tengelmann/Lampensteuerung/Web/files/v3_single/v.3 Bestueckung BottomView.TIF

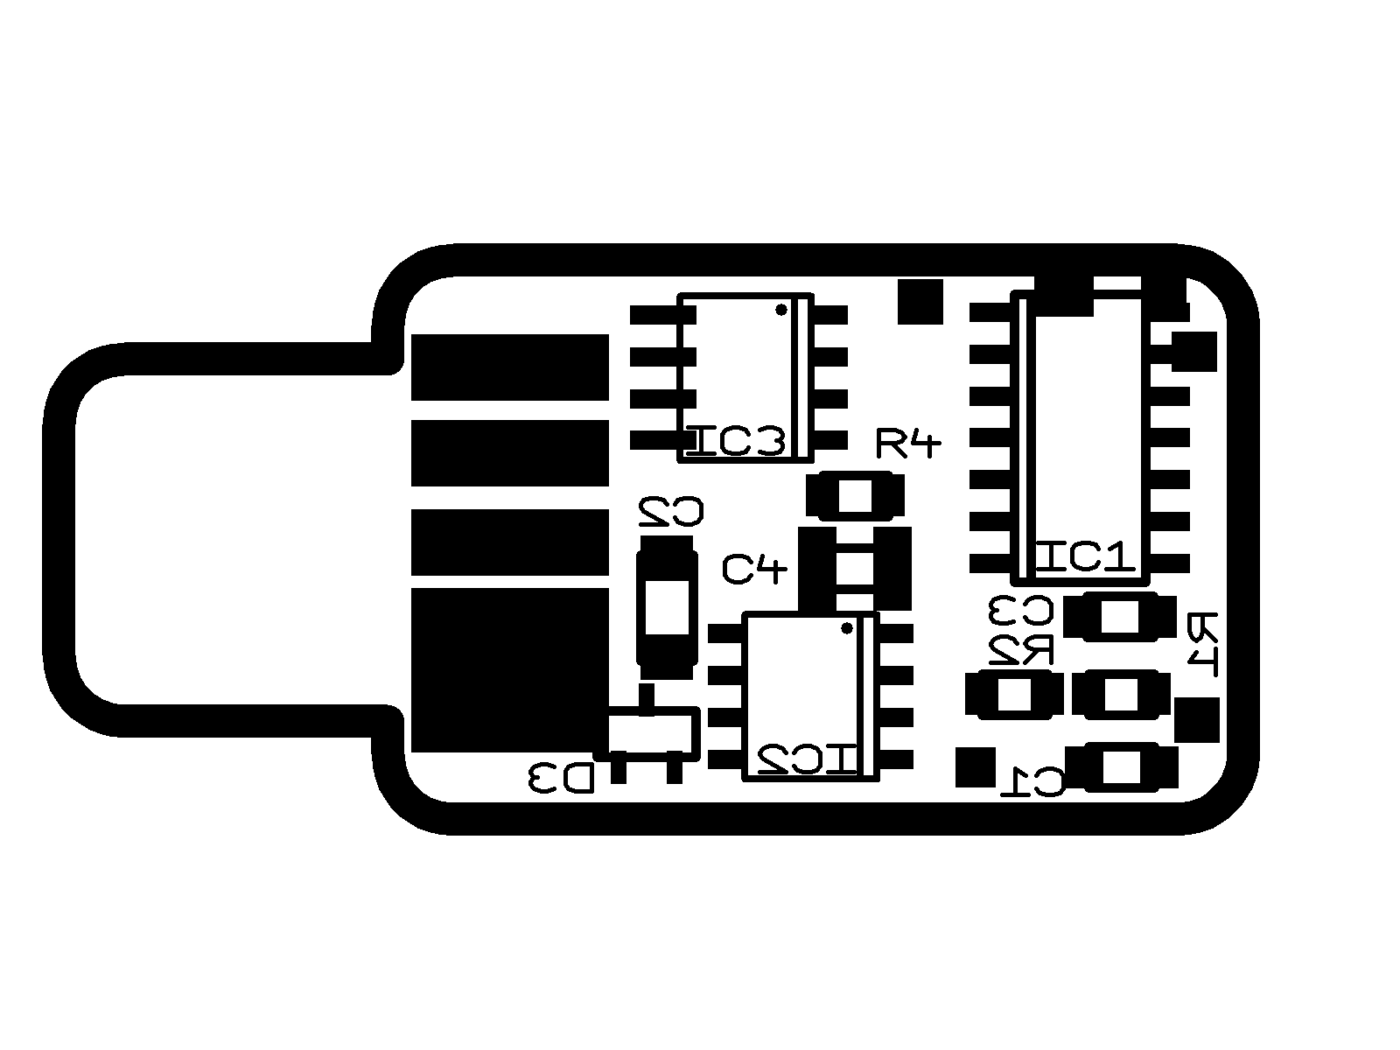
Web/files/v3_single/v.3 Bestueckung BottomView.TIF
