tengelmann/Lampensteuerung/Web/files/v3_single/v.3 Bestueckung TopView.TIF

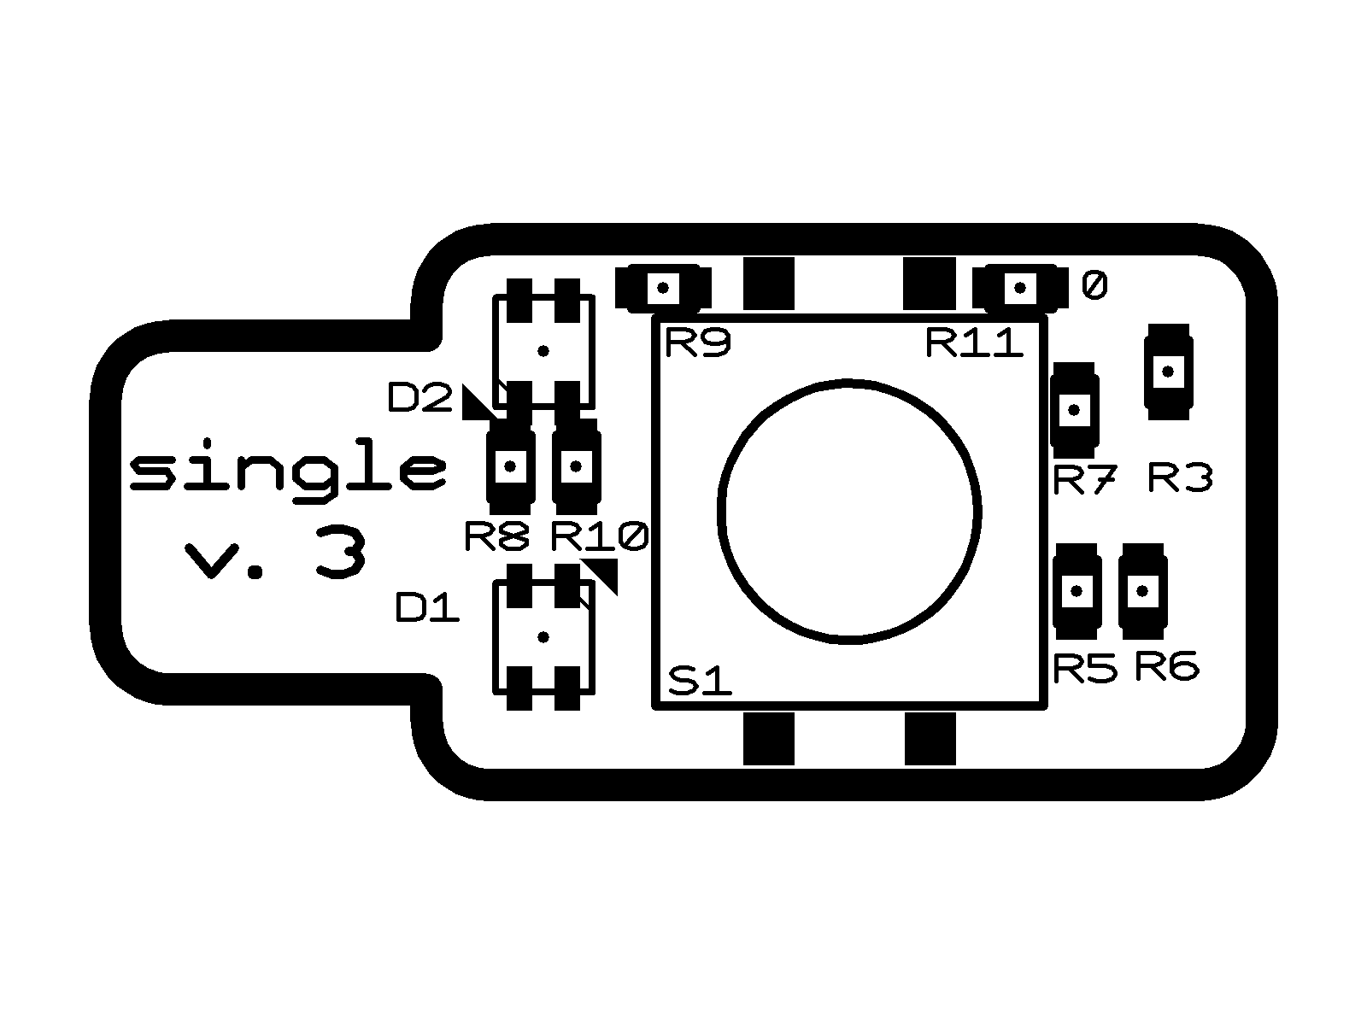
Web/files/v3_single/v.3 Bestueckung TopView.TIF
