tengelmann/Lampensteuerung/Web/images/duov2/duov2.jpg

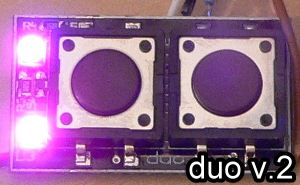
Web/images/duov2/duov2.jpg
