tengelmann/Lampensteuerung/Web/images/duov2/lampe_komplett.jpg

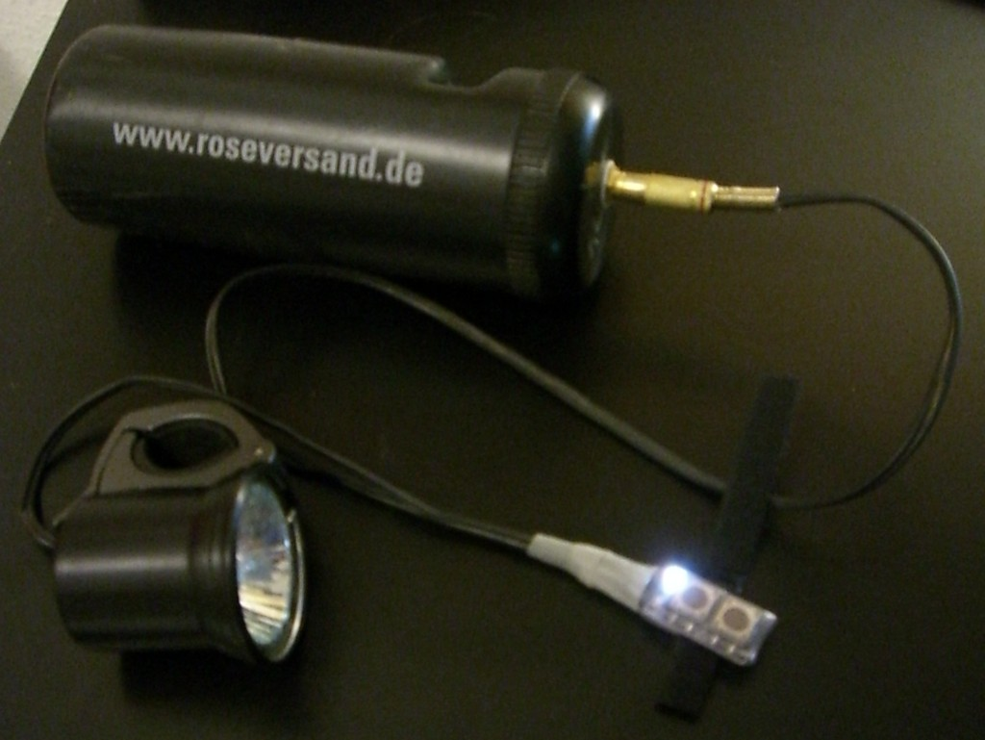
Web/images/duov2/lampe_komplett.jpg
