tengelmann/Lampensteuerung/Web/images/duov2/lenker.jpg

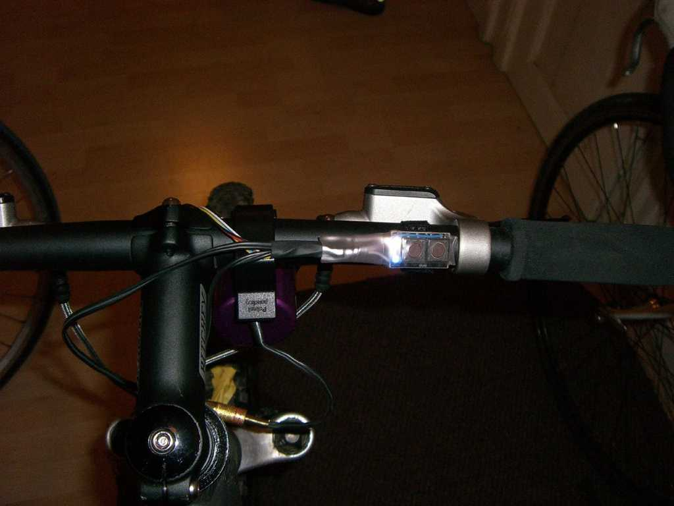
Web/images/duov2/lenker.jpg
