tengelmann/Lampensteuerung/Web/images/duov2/lenker_2.jpg

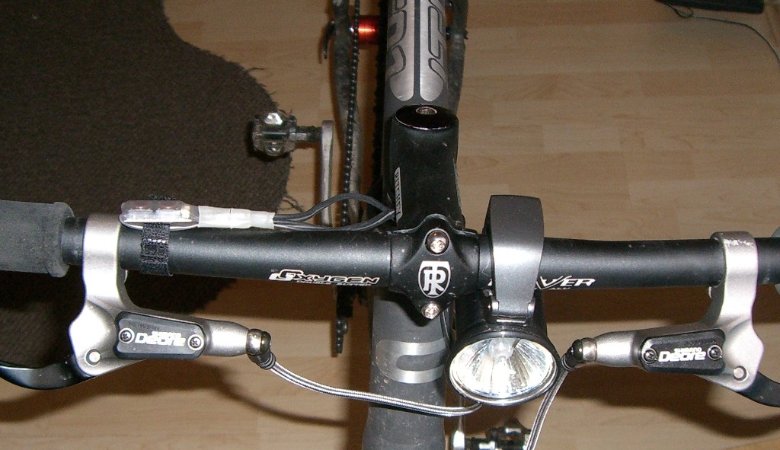
Web/images/duov2/lenker_2.jpg
