tengelmann/Lampensteuerung/Web/images/duov2/lenker_3.jpg

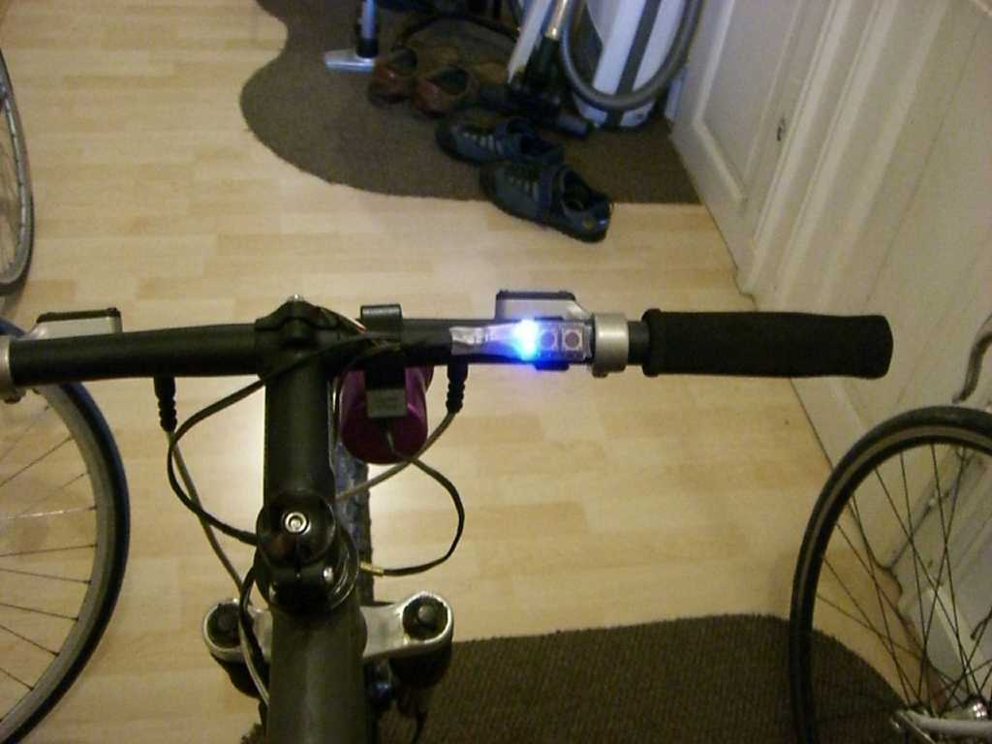
Web/images/duov2/lenker_3.jpg
