tengelmann/Lampensteuerung/Web/images/singlev3.jpg

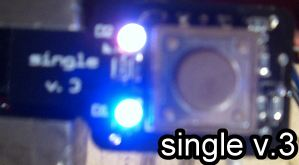
Web/images/singlev3.jpg
