tengelmann/Lampensteuerung/Web/images/singlev3/singlev3_breite.jpg

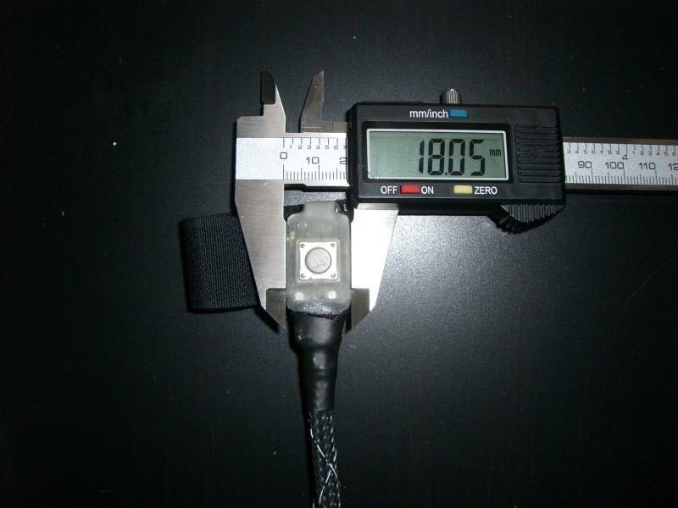
Web/images/singlev3/singlev3_breite.jpg
