tengelmann/Lampensteuerung/Web/images/singlev3/singlev3_set.JPG

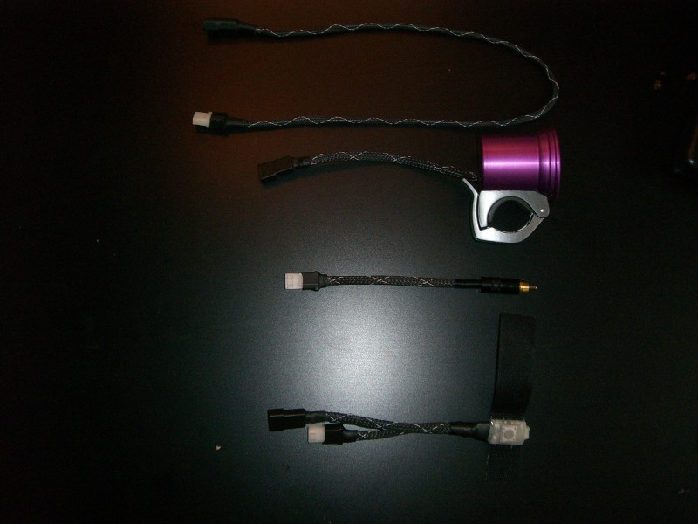
Web/images/singlev3/singlev3_set.JPG
