tengelmann/Lampensteuerung/Web/images/singlev3/singlev3_set_mit_akku.JPG

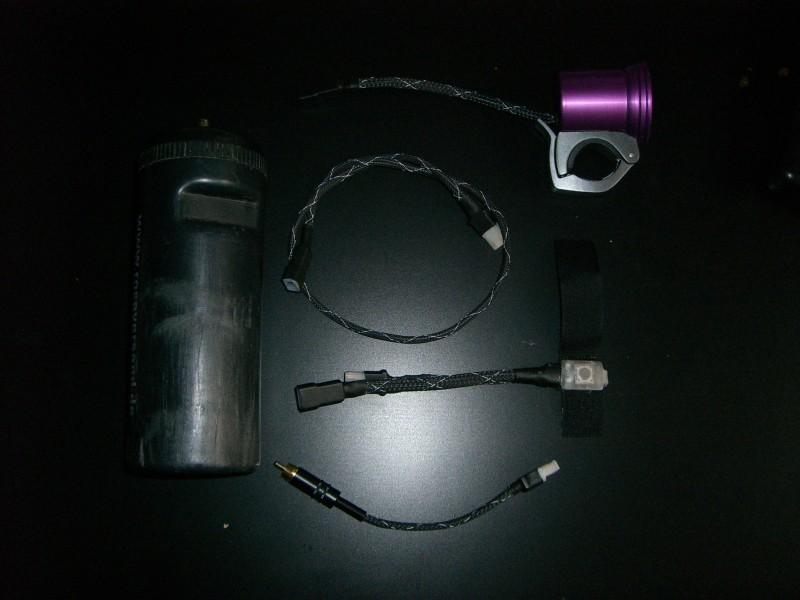
Web/images/singlev3/singlev3_set_mit_akku.JPG
