tengelmann/Lampensteuerung/Web/images/singlev3/singlev3_vergleich_2euro.jpg

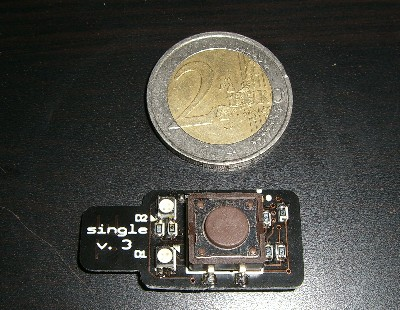
Web/images/singlev3/singlev3_vergleich_2euro.jpg
