tengelmann/Lampensteuerung/Web/images/sis.jpg

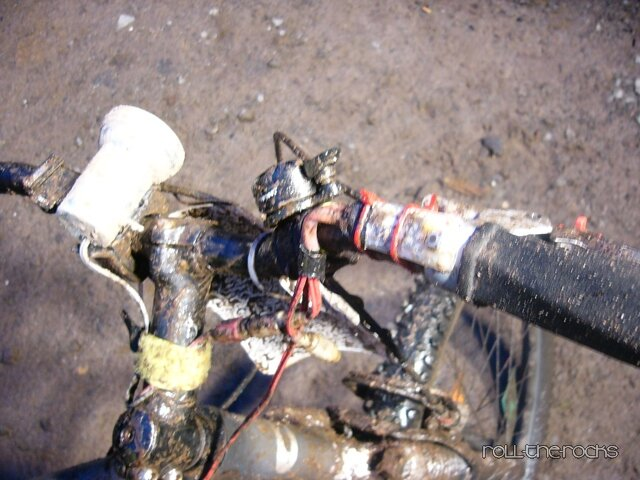
Web/images/sis.jpg
