tengelmann/Lampensteuerung/Web/images/skizze_verkabelung.gif

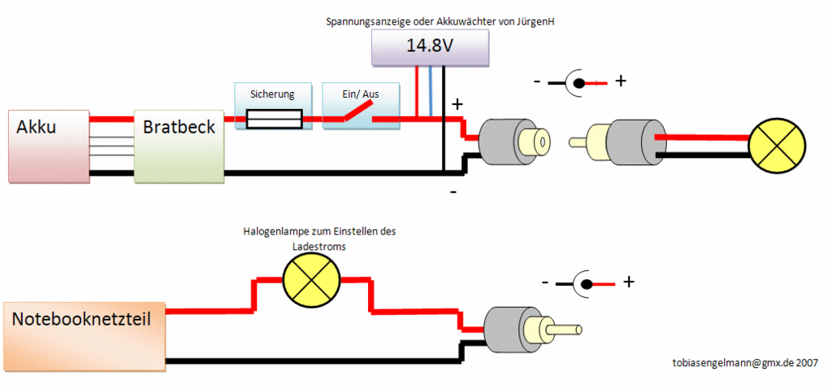
Web/images/skizze_verkabelung.gif
