tengelmann/Lampensteuerung/Web/images/wald.JPG

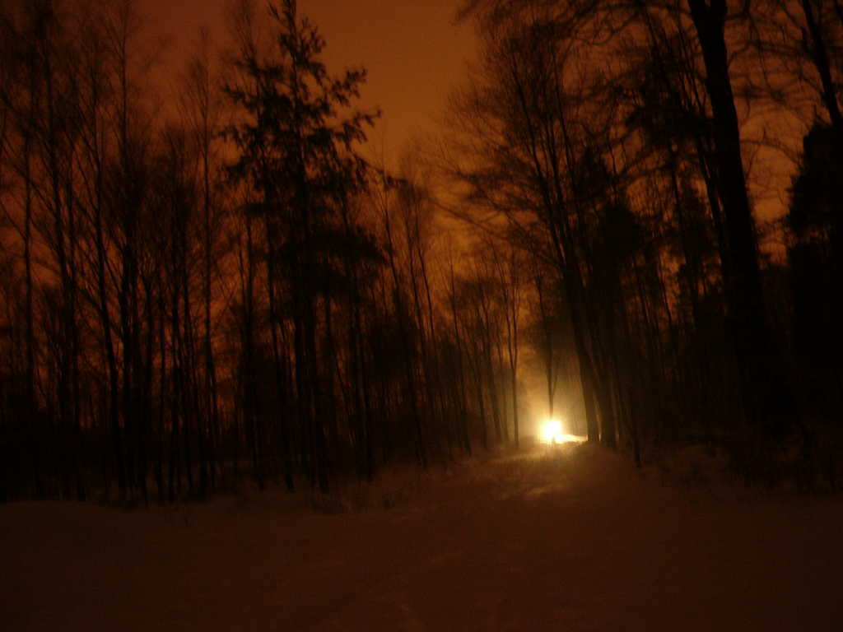
Web/images/wald.JPG
