tengelmann/Lampensteuerung/Web/files/v2_duo/v.2 Stueckliste.xls

2007-12-20
Duo v.2 - 2 Ausgänge - Vcc=5V
 | Wert | Bauform | Anzahl | Reichelt | € | Conrad | € | eBay | € | €
C1 | KERKO 2,2µF 16V | 0805 oder 1206 | 1 |  |  | 445343 - 62 | 0.08 € |  |  | 0.08 €
C2 | KERKO 1µF 25V | 1206 | 1 |  |  | 445475 - 62 | 0.17 € |  |  | 0.17 €
C3 | Kerko 100nF | 0805 oder 1206 | 1 |  |  | 445198-62 | 0.08 € |  |  | 0.08 €
C4 | KERKO 2,2µF 16V | 0805 oder 1206 | 1 |  |  | 445343 - 62 | 0.08 € |  |  | 0.08 €
D1 | BAS 40-05 (Dual) | SOT23 | 1 |  |  | 153221 - 62 | 0.16 € |  |  | 0.16 € | oder BAV70, Bat54C, Bas40-05
D2 | LED-SMD RGB | PLCC4, Common Anode | 2 |  |  |  |  | ebay z.b. led-baron.de | 0.60 € | 1.20 €
D3 | LED-SMD RGB | PLCC4, Common Anode
IC1 | ATTINY44-20SSU | SO14 | 1 | ATTINY 44-20 SSU | 2.10 € |  |  | csd-electronics.de (*2) | 2.40 € | 2.40 € | oder ATTINY44V-10SSU
IC2 | TA 78 L05 F | HSOP3 | 1 |  |  | 144711 - 62 | 0.71 € |  |  | 0.71 €
IC3 | IRF7313 (6,5A) | SO8 | 1 |  |  | 162452-J7 | 0.87 € |  |  | 0.87 €
R1 | 22K | 0805 | 3 | SMD-0805 22,0K | 0.10 € | 406414 - 62 | 0.10 € |  |  | 0.30 €
R2 | 68K | 0805 | 1 | SMD-0805 68,0K | 0.10 € | 406473 - 62 | 0.10 € |  |  | 0.10 €
R3 | 22K | 0805
R4 | 22K | 0805
R5 | 820 | 0805 | 6 | SMD-0805 820 | 0.10 € | 406244-J7 | 0.10 € |  |  | 0.60 €
R6 | 820 | 0805
R7 | 820 | 0805
R8 | 820 | 0805
R9 | 820 | 0805
R10 | 820 | 0805
S1 | DTSM 21 - Tactile Switch SMT Type 12x12 |  | 1 |  |  | 707589 - 62 | 0.64 € | csd-electronics.de (Art.Nr. 351205) | 0.28 € | 0.64 €
 |  |  |  |  |  |  |  |  |  | 7.39 €
Mail: | tobiasengelmann@gmx.de
ICQ: | 59634313
