tengelmann/Lampensteuerung/Web/files/v3_single/v.3 Stueckliste.xlsx

2007-08-02
Single v.3 Normal - 2 Ausgänge - Vcc=5V
 | Wert | Bauform | Anzahl | Reichelt | € | Conrad | € | eBay | € | €
C1 | KERKO 2,2µF 16V | 0805 | 1 |  |  | 445343 - 62 | 0.08 € |  |  | 0.08 €
C2 | KERKO 1µF 25V | 1206 | 1 |  |  | 445475 - 62 | 0.17 € |  |  | 0.17 €
C3 | Kerko 100nF | 0805 | 1 |  |  | 445198-62 | 0.08 € |  |  | 0.08 €
C4 | KERKO 2,2µF 16V | 0805 | 1 |  |  | 445343 - 62 | 0.08 € |  |  | 0.08 €
D1 | BAS 40-05 (Dual) | SOT23 | 1 |  |  | 153221 - 62 | 0.16 € |  |  | 0.16 €
D2 | LED-SMD RGB | PLCC4, Common Anode | 2 |  |  |  |  | ledbaron.de | 0.60 € | 1.20 €
D3 | LED-SMD RGB | PLCC4, Common Anode
IC1 | ATtiny44 | SO14 | 1 | ATTINY 44-20 SSU | 2.10 € |  |  | csd-electronics.de | 2.40 € | 2.40 €
IC2 | L78L05ACD | SO8 | 1 |  |  | 156058 - 62 | 0.23 € |  |  | 0.23 €
IC3 | IRF7313 (6,5A) | SO8 | 1 |  |  | 162452-J7 | 0.87 € |  |  | 0.87 €
R1 | 22K | 0805 | 3 | SMD-0805 22,0K | 0.10 € | 406414 - 62 | 0.10 € |  |  | 0.30 €
R2 | 68K | 0805 | 1 | SMD-0805 68,0K | 0.10 € | 406473 - 62 | 0.10 € |  |  | 0.10 €
R3 | 22K | 0805
R4 | 22K | 0805
R5 | 820 | 0805 | 6 | SMD-0805 820 | 0.10 € | 406244-J7 | 0.10 € |  |  | 0.60 €
R6 | 820 | 0805
R7 | 820 | 0805
R8 | 820 | 0805
R9 | 820 | 0805
R10 | 820 | 0805
R11 | 0 | 0805 | 1 |  |  | 406007 - 62 | 0.10 € |  |  | 0.10 €
S1 | DTSM 21 - Tactile Switch SMT Type 12x12 |  | 1 |  |  | 707589 - 62 | 0.64 € |  |  | 0.64 €
 |  |  |  |  |  |  |  |  |  | 7.01 €
Mail: | tobiasengelmann@gmx.de
ICQ: | 59634313
Single v.3 Low Voltage - 2 Ausgänge - Vcc=3,3V
 | Wert | Bauform | Anzahl | Reichelt | € | Conrad | € | eBay | € | €
R2 | 115K | 0805 | 1 | SMD-0805 115K | 0.10 € |  |  |  |  | 0.10 €
R5 | 560 | 0805 | 4 | SMD-0805 560 | 0.10 € |  |  |  |  | 0.40 €
R6 | 150 | 0805 | 2 | SMD-0805 150 | 0.10 € |  |  |  |  | 0.20 €
R7 | 560 | 0805
R8 | 560 | 0805
R9 | 560 | 0805
R10 | 150 | 0805
IC2 | L4931CD33 | SO8 | 1 |  |  | 156127 - 62 | 1.22 € |  |  | 1.22 €
IC3 | IRF7301 | SO8 | 1 |  |  | 162443 - 62 | 0.91 € |  |  | 0.91 €
Alle anderen Teile, wie die normale Version.
Single v.3 Low Voltage - Beide Lampenausgänge gekoppelt
 | Wert | Bauform | Anzahl | Reichelt | € | Conrad | € | eBay | € | €
R11, R3 | unbestückt
IC3 | IRF7456 | SO8 | 1 |  |  | 162481 - 62 | 1.33 € |  |  | 1.33 €
Alle anderen Teile, wie normale oder Low-Volt-Version.
