tengelmann/Lampensteuerung/Web/files/v3_single_mod_strommessung/v.3 mit Strommessung Stueckliste.xlsx

2007-08-06
Single v.3 Dicke Platine - 1 Ausgang - Vcc=5V
 | Wert | Bauform | Anzahl | Reichelt | € | Conrad | € | eBay | € | €
C1 | KERKO 2,2µF 16V | 0805 | 1 |  |  | 445343 - 62 | 0.08 € |  |  | 0.08 €
C2 | KERKO 1µF 25V | 1206 | 1 |  |  | 445475 - 62 | 0.17 € |  |  | 0.17 €
C3 | Kerko 100nF | 0805 | 1 |  |  | 445198-62 | 0.08 € |  |  | 0.08 €
C4 | KERKO 2,2µF 16V | 0805 | 1 |  |  | 445343 - 62 | 0.08 € |  |  | 0.08 €
D1 | LED-SMD RGB | PLCC4, Common Anode | 2 |  |  |  |  | ledbaron.de | 0.60 € | 1.20 €
D2 | LED-SMD RGB | PLCC4, Common Anode
D8 | BAS 40-05 (Dual) | SOT23 | 1 |  |  | 153221 - 62 | 0.16 € |  |  | 0.16 €
IC1 | ATtiny44 | SO14 | 1 | ATTINY 44-20 SSU | 2.10 € |  |  | csd-electronics.de | 2.40 € | 2.40 €
IC2 | L78L05ACD | SO8 | 1 |  |  | 156058 - 62 | 0.23 € |  |  | 0.23 €
IC3 | IRF7313 (6,5A) | SO8 | 1 |  |  | 162452-J7 | 0.87 € |  |  | 0.87 €
R1 | 22K | 0805 | 2 | SMD-0805 22,0K | 0.10 € | 406414 - 62 | 0.10 € |  |  | 0.20 €
R2 | 68K | 0805 | 1 | SMD-0805 68,0K | 0.10 € | 406473 - 62 | 0.10 € |  |  | 0.10 €
R3 | 0 | 0805 | 1 |  |  | 406007 - 62 | 0.10 € |  |  | 0.10 €
R4 | 22K | 0805
R5 | 820 | 0805 | 6 | SMD-0805 820 | 0.10 € | 406244-J7 | 0.10 € |  |  | 0.60 €
R6 | 820 | 0805
R7 | 820 | 0805
R8 | 820 | 0805
R9 | 820 | 0805
R10 | 820 | 0805
R11* | unbestückt | 0805
S1 | DTSM 21 - Tactile Switch SMT Type 12x12 |  | 1 |  |  | 707589 - 62 | 0.64 € |  |  | 0.64 €
 |  |  |  |  |  |  |  |  |  | 6.91 €
