tengelmann/Lampensteuerung/Docs/Berechnungen/IRF-Typen in der Übersicht.xlsx

Sheet: IRF Übersicht
Übersicht IRF
Dual-N-Kanal, 5V
IRF | Vdss | Rdson@10V | Rdson@4,50V | Rdson@2,8V | I @ 25°C | I @ 70°C | GC |  |  | 1 | 10 | 25
IRF9910PBF | 20 V | 13.4 mΩ | 18.3 mΩ |  | 10.0 A | 8.3 A |  | rsonline.de |  |  | 1.41 € | 1.28 €
IRF7904UPBF | 30 V | 16.2 mΩ | 20.5 mΩ |  | 7.6 A | 8.9 A
IRF8915 | 20 V | 18.3 mΩ | 27.0 mΩ |  | 8.9 A | 7.1 A
IRF7311 | 20 V |  | 29.0 mΩ | 46.0 mΩ | 6.6 A | 5.3 A | 18.0 nC | Conrad | 162451 - 62 | 2.33 € | 2.09 € | 1.77 €
IRF7331PBF | 20 V |  | 30.0 mΩ | 45.0 mΩ | 7.0 A | 5.5 A |  | Farnell | 9103465 | 1.15 € |  | 0.66 €
IRF7313 | 20 V | 29.0 mΩ | 46.0 mΩ |  | 6.5 A | 5.2 A | 22.0 nC | Conrad | 162452-J7 | 0.89 € | 0.79 € | 0.67 €
IEF7301 | 20 V |  | 50.0 mΩ | 70.0 mΩ | 5.2 A | 4.1 A |  | Conrad | 162443 - 62 | 0.91 € | 0.82 € | 0.70 €
IRF7341 | 55 V | 50.0 mΩ | 56.0 mΩ |  | 4.7 A | 3.8 A | 24.0 nC | Conrad | 162457 - 62 | 1.28 €
IRF7303 | 30 V | 50.0 mΩ |  |  | 4.9 A | 3.9 A |  | Conrad | 162444 - 62 | 1.50 €
IRF8910 | 20 V | 13.4 mΩ |  |  | 10.0 A | 8.3 A
Single-N-Channel, 5V |  |  |  |  |  |  |  |  |  | 1 | 10 | 25
IRF7831 | 30 V | 3.6 mΩ | 4.4 mΩ |  | 21.0 A | 17.0 A | 40.0 nC | Conrad | 164357 - 62 | 2.99 € | 2.79 € | 2.25 €
IRF7456 (https://ec.irf.com/v6/en/US/adirect/ir?cmd=catSearchFrame&domSendTo=byID&domProductQueryName=IRF7456) | 20 V | 6.5 mΩ | 7.5 mΩ | 20.0 mΩ | 16.0 A | 10.0 A | 41.0 nC | Conrad | 162481 - 62 | 1.33 € | 1.20 € | 1.02 €
IRF7476 (https://ec.irf.com/v6/en/US/adirect/ir?cmd=catSearchFrame&domSendTo=byID&domProductQueryName=IRF7476) |  |  | 8.0 mΩ | 30.0 mΩ | 15.0 A | 12.0 A
IRF7455 | 30 V | 7.5 mΩ | 9.0 mΩ | 20.0 mΩ | 15.0 A | 10.0 A |  | Conrad | 162480 - 62 | 3.99 € | 3.43 € | 3.07 €
IRF7457 | 20 V | 7.0 mΩ | 10.5 mΩ |  | 15.0 A | 12.0 A |  | Conrad | 162482 - 62 | 1.63 €
IRF7459 (https://ec.irf.com/v6/en/US/adirect/ir?cmd=catSearchFrame&domSendTo=byID&domProductQueryName=IRF7459) | 20 V | 9.0 mΩ | 11.0 mΩ | 22.0 mΩ | 10.0 A | 8.0 A |  | Conrad | 162484 - 62 | 1.42 € | 1.27 € | 1.08 €
IRF7413 | 30 V | 11.0 mΩ | 18.0 mΩ |  | 13.0 A | 9.2 A | 44.0 nC | Reichelt | IRF 7413 (http://www.reichelt.de/) | 0.67 €
 |  |  |  |  |  |  |  | CSD | 137372 | 0.61 € |  | 0.45 €
IRF7413 | 30 V | 11.0 mΩ | 18.0 mΩ |  | 13.0 A | 9.2 A |  | Conrad | 162474 - 62 | 1.02 €
IRF7403 | 30 V | 22.0 mΩ | 35.0 mΩ |  | 8.5 A | 5.4 A |  | Reichelt | IRF 7403 (http://www.reichelt.de/) | 0.43 €
SI4966DY | 20 V | 25.0 mΩ |  |  | 7.2 A |  |  | Farnell |  | 0.9
162452-S3 IRF 7313 SO 8 30 V 25°C@6.5 A 0.029 Ohm (http://www1.business.conrad.de/scripts/wgate/zcop_b2b/~flN0YXRlPTIxNjczMjY3MDA=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)

Sheet: Tabelle1
 |  |  |  |  | 1 | 10 | 50 | 100
805 | 25 | 2.2 | Farnell | 9527702 (http://de.farnell.com/jsp/Passive+Bauelemente/Kondensatoren/MURATA/GRM21BF51E225ZA01L/displayProduct.jsp?sku=9527702) |  | 0.06 € | 0.05 € | 0.04 €
805 | 6.3 | 4.7 |  | 5212832 (http://de.farnell.com/jsp/Passive+Bauelemente/Kondensatoren/EPCOS/B37641K7475K62/displayProduct.jsp?sku=5212832) |  | 0.11 € | 0.09 € | 0.08 €
1206 | 10 | 10 |  | 9527745 (http://de.farnell.com/jsp/Passive+Bauelemente/Kondensatoren/MURATA/GRM31MF51A106ZA01L/displayProduct.jsp?sku=9527745) |  | 0.12 € | 0.10 € | 0.10 €
1206 | 6.3 | 22 |  | 1288265 |  | 0.59 € |  | 0.50 €
805 | 6.3 | 10 |  | 9227814 |  | 0.29 € |  | 0.26 €
1206 | 6.3 | 10 |  | 9527729 |  | 0.17 € | 0.14 € | 0.13 €
