tengelmann/Lampensteuerung/(list of files, cad)

Other CAD files:
Firmware/AVRootloader/AVR/AVRootloader.obj
Firmware/AVRootloader/Test/AVR/AVRootloader.obj
