tengelmann/Lampensteuerung/Docs/Anleitung/Images/singlev.3 KTY11-5 auf Ledträger T6.jpg

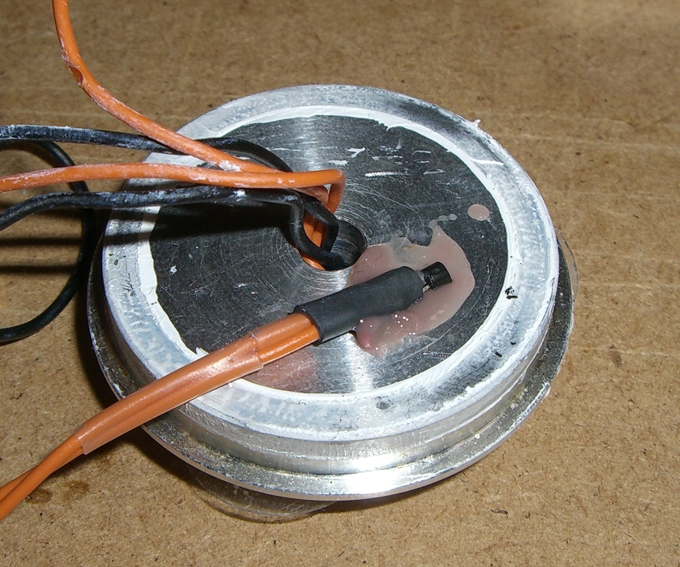
Docs/Anleitung/Images/singlev.3 KTY11-5 auf Ledträger T6.jpg
