tengelmann/Lampensteuerung/Docs/Anleitung/Images/singlev.3 KTY11-5 Kabel an Steuerung.jpg

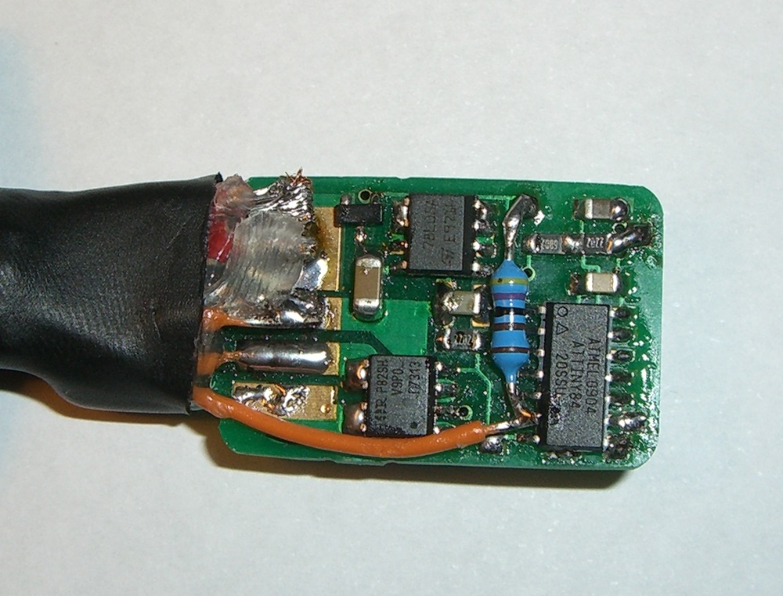
Docs/Anleitung/Images/singlev.3 KTY11-5 Kabel an Steuerung.jpg
