tengelmann/Lampensteuerung/Docs/Anleitung/Images/singlev.3 KTY11-5 Mini-To-92.jpg

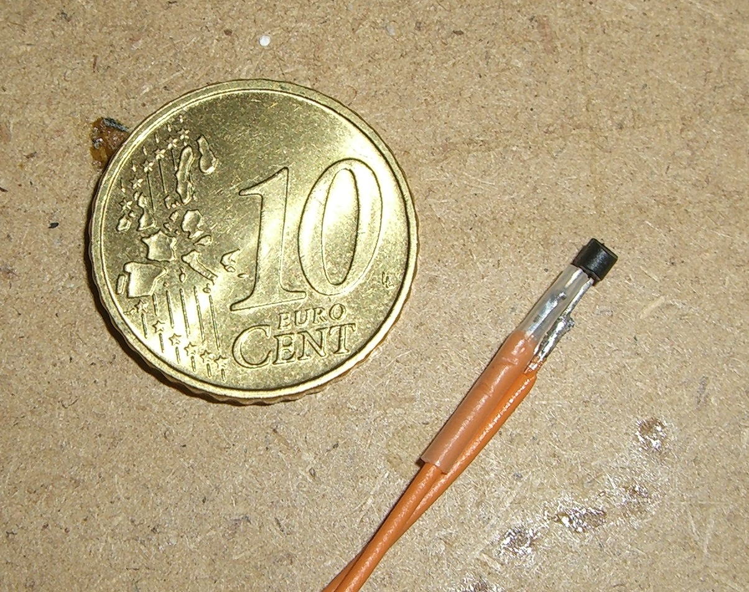
Docs/Anleitung/Images/singlev.3 KTY11-5 Mini-To-92.jpg
