tengelmann/Lampensteuerung/Docs/Anleitung/Images/singlev.3 KTY11-5.jpg

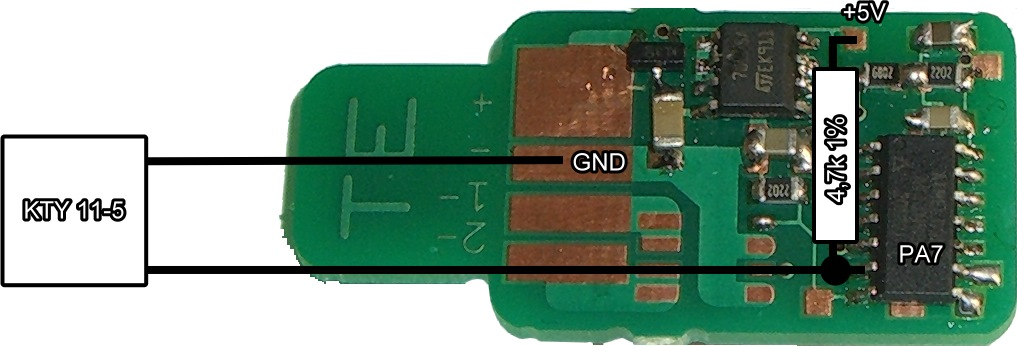
Docs/Anleitung/Images/singlev.3 KTY11-5.jpg
