tengelmann/Lampensteuerung/Docs/Anleitung/Images/singlev.3 Rs232 TTL verkabelt.jpg

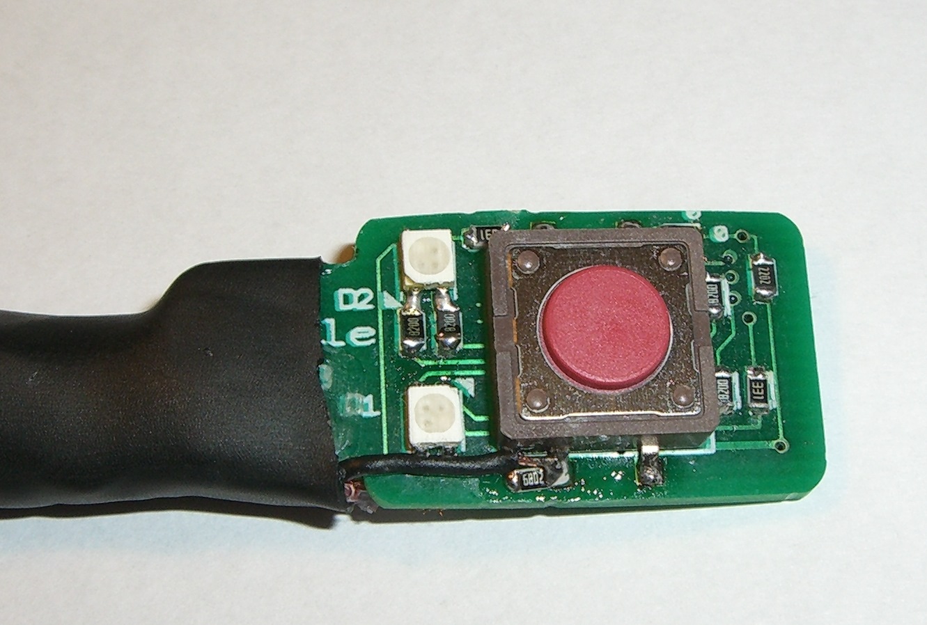
Docs/Anleitung/Images/singlev.3 Rs232 TTL verkabelt.jpg
