tengelmann/Lampensteuerung/Docs/Anleitung/Images/v.3 vs v.4.jpg

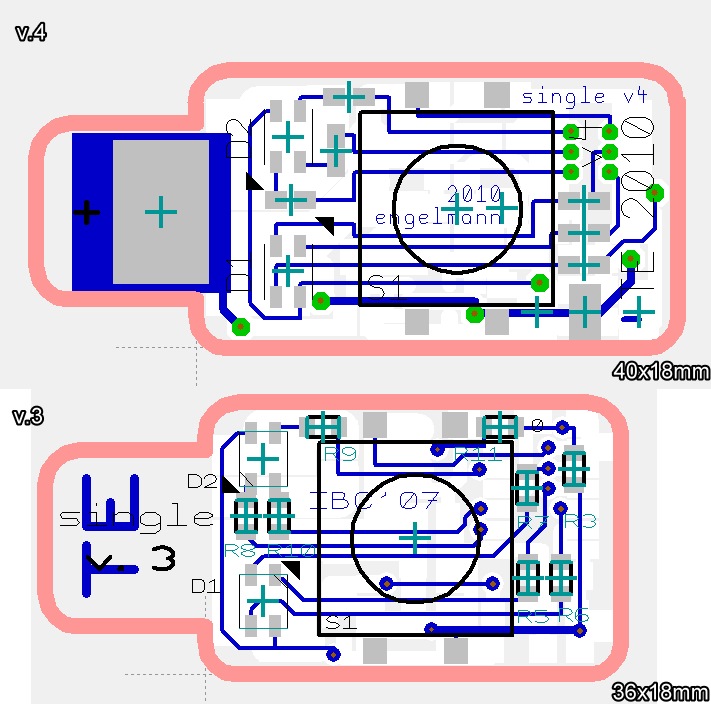
Docs/Anleitung/Images/v.3 vs v.4.jpg
