tengelmann/Lampensteuerung/Web/images/Anleitung/01 Kabel anloeten.jpg

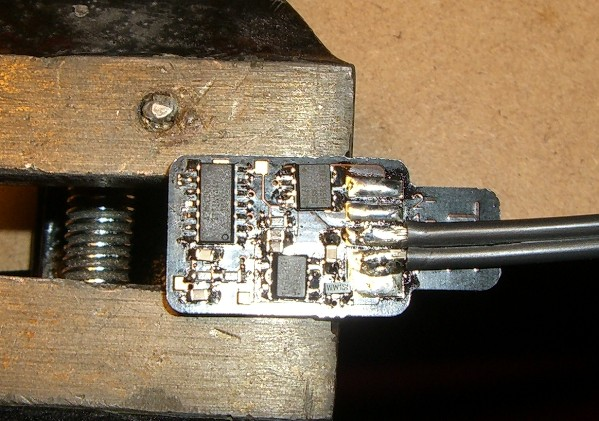
Web/images/Anleitung/01 Kabel anloeten.jpg
