tengelmann/Lampensteuerung/Web/images/Anleitung/02 Kabel mit Heisskleber fixieren.jpg

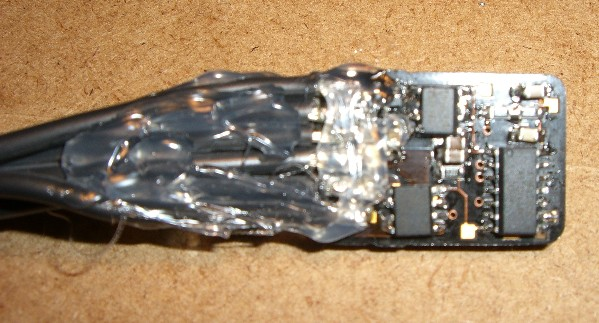
Web/images/Anleitung/02 Kabel mit Heisskleber fixieren.jpg
