tengelmann/Lampensteuerung/Web/images/Anleitung/03 Erste Lage Schrumpfschlauch.jpg

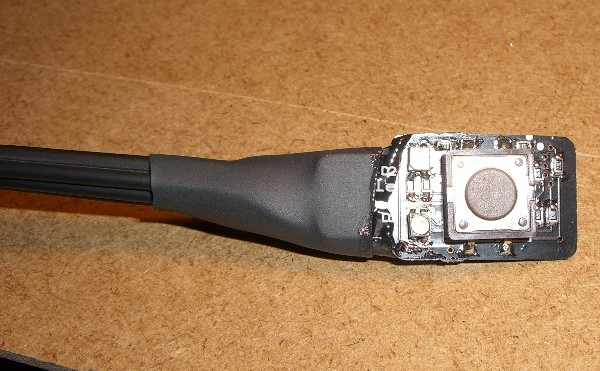
Web/images/Anleitung/03 Erste Lage Schrumpfschlauch.jpg
