tengelmann/Lampensteuerung/Web/images/Anleitung/04 nochmal etwas Heisskleber.jpg

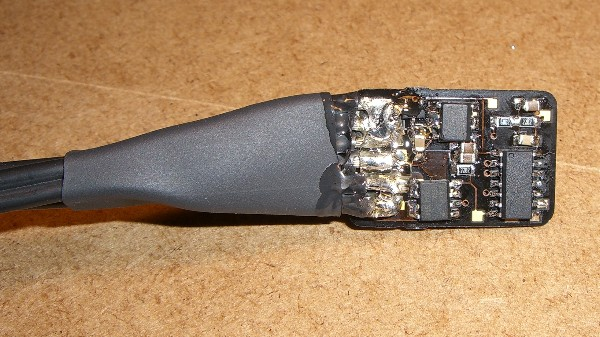
Web/images/Anleitung/04 nochmal etwas Heisskleber.jpg
