tengelmann/Lampensteuerung/Web/images/Anleitung/05 Zweite Lage schwarzer Schrumpfschlauch danach transparenter Schrumpfschlauch.jpg

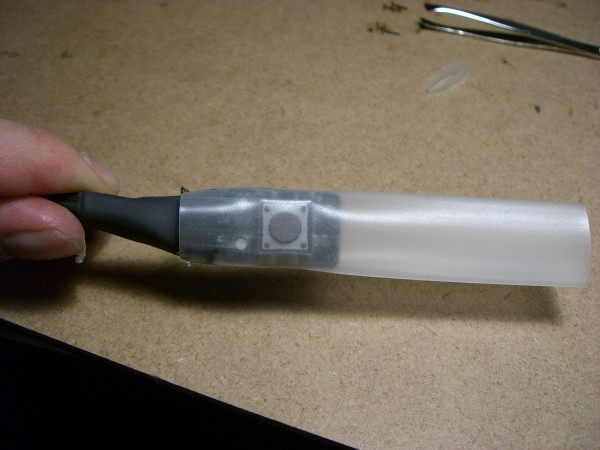
Web/images/Anleitung/05 Zweite Lage schwarzer Schrumpfschlauch danach transparenter Schrumpfschlauch.jpg
