tengelmann/Lampensteuerung/Web/images/Anleitung/06 transparenten Schrumpfschlauch schrumpfen.jpg

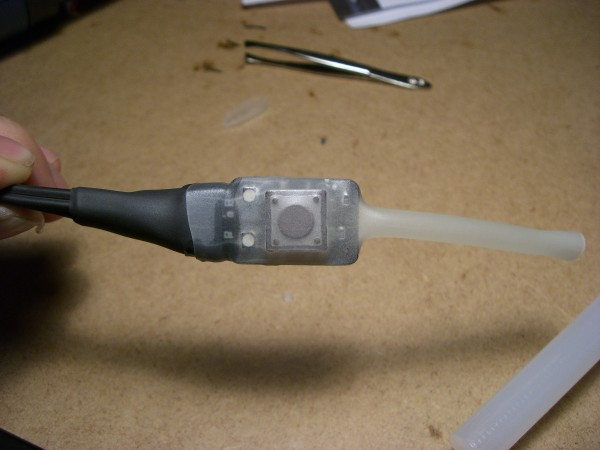
Web/images/Anleitung/06 transparenten Schrumpfschlauch schrumpfen.jpg
