tengelmann/Lampensteuerung/Web/images/Anleitung/07 Ende des transparenten Schrumpflauches hinten umlegen und eine Lage schwarzen Schrumpfschlauch zum Fixieren.jpg

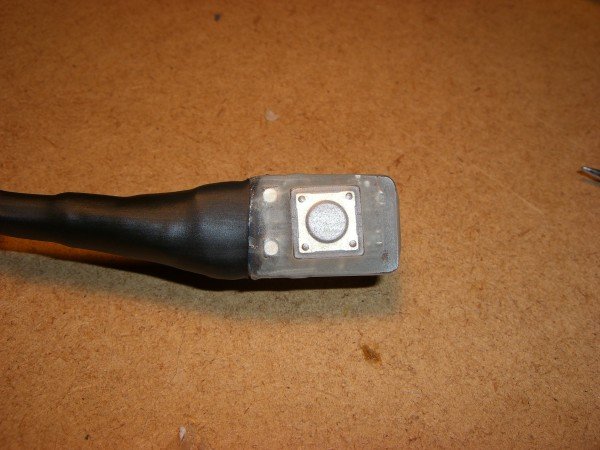
Web/images/Anleitung/07 Ende des transparenten Schrumpflauches hinten umlegen und eine Lage schwarzen Schrumpfschlauch zum Fixieren.jpg
