tengelmann/Lampensteuerung/Web/images/Anleitung/08 Klettband zur Lenkerbefestigung.jpg

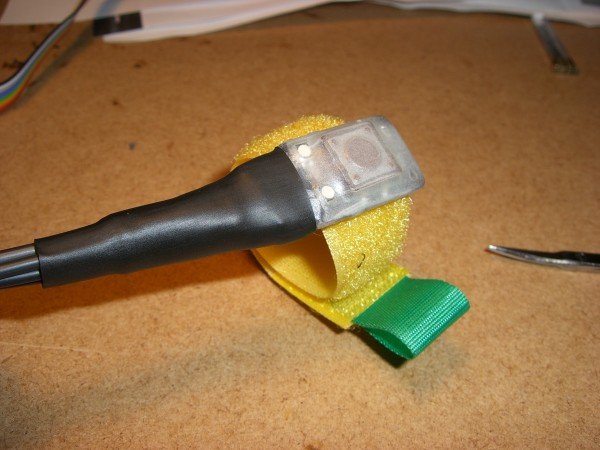
Web/images/Anleitung/08 Klettband zur Lenkerbefestigung.jpg
