tengelmann/Lampensteuerung/Web/images/Anleitung/09 Fertige Steuerung mit Anschlusskabeln.jpg

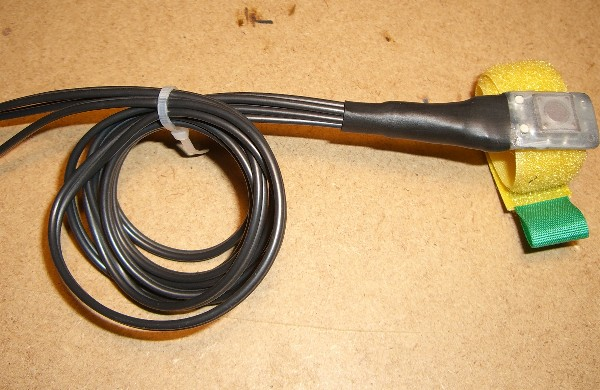
Web/images/Anleitung/09 Fertige Steuerung mit Anschlusskabeln.jpg
