tengelmann/Lampensteuerung/Firmware/v2_Duo/controller_debug.h

/***************************************************************************
 *
 * Copyright (c) 2006,2007 Tobias Engelmann
 * 
 * Digitale Lampensteuerung "Duo v.2"
 *
 * http://www.mtb-news.de/forum/showthread.php?p=2458216
 *
 * Mail: tobiasengelmann@gmx.de
 * ICQ: 59634313
 *
 * controller_debug.h
 *
 * Debug-Routinen
 *
 * 09.01.2007
 *
 ***************************************************************************/
#ifndef CONTROLLER_DEBUG_H
	#define CONTROLLER_DEBUG_H
	
	#include "controller.h"

	#ifdef DEBUG
		void sendHourCounter(void);
		void sendRunTime(void);
		void sendState(void);
		void sendADCValues(void);
		void sendButtonState(void);
		void sendVersion(void);
		void sendDimLevel(void);
		void sendTransTableIndex(void);
		void sendPWM(void);
		void sendRemainingTime(void);
		void sendCapacity(void);
		void sendPWMTable(void);
		void sendVoltTable(void);
		void sendCalibTable(void);
	#endif
#endif
