tengelmann/Lampensteuerung/Firmware/v2_Duo/timer.h

/***************************************************************************
 *
 * Copyright (c) 2006, Tobias Engelmann
 * 
 * Digitale Lampensteuerung "Duo v.2"
 *
 * http://www.mtb-news.de/forum/showthread.php?p=2458216
 *
 * Mail: tobiasengelmann@gmx.de
 * ICQ: 59634313
 *
 * timer.c
 *
 * Timer für Prozesssteuerung
 *
 * 16.12.2006
 *
 ***************************************************************************/

#ifndef TIMER_H
	#define TIMER_H
	
	//Struct für Zeitberechnungen
	typedef struct
	{
	    uint16_t t_count;
	    uint8_t sec10;		// global 1/10 seconds
		uint8_t sec;		// global seconds
	    uint8_t min;		// global minutes
	    uint8_t hour;		// global hour
		uint8_t waitSecs;	// Zähler für Wartezeit, wird runtergezählt, wenn gesetzt
		uint8_t waitMins;	// Zähler für Wartezeit, wird runtergezählt, wenn gesetzt
		uint8_t softPwmCnt; // Zähler für Software-PWM der Leds
	} time_struct;

	//Variable für Zeitmessung
	volatile time_struct time; 

	//Timerflags
	#define TF_MINUTE 1
	#define TF_SECOND 2
	#define TF_10SSECOND 3
	volatile uint8_t timerFlags;

	void timerInitialize(void);
#endif
