tengelmann/Lampensteuerung/(commit log)

2017-10-28 First commit of old project files
    [AVRootloader.obj, Project1.cfg]
2017-10-28 Commit old web page and schematics
    [Stueckliste v2 Duo 5.0V.xlsx, v.2 Stueckliste.xls, v.2 Stueckliste.xlsx, v.3 Stueckliste.xlsx, v.3 mit Strommessung Stueckliste.xlsx]
2017-10-28 Commit old web docs
    [Berechnungen Akkuspannung mit Offset.xlsx, Berechnungen interne Temperaturmessung.xlsx, Halogen 20W 35W 50W Leistungsdiagramme.xlsx, IRF-Typen in der Übersicht.xlsx, KTY11-5.xlsx, Konstantspannungsausgabe.xls, RGB-Leds Leistung, Vorwiderstände, PWM.xlsx, Schaltverluste PWM 20W 35W 50W.xlsx]
